kumpakri/diy-differencial-drive-robot/img/scheme_stage2_LDO.png

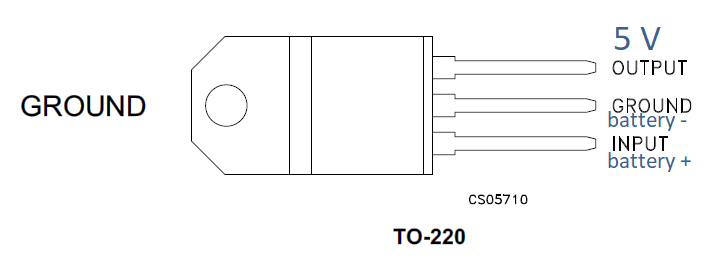
img/scheme_stage2_LDO.png
