kumpakri/diy-differencial-drive-robot/src/main/main.ino

/*
* |ARDUINO PINS USAGE          |
* |----|-----------------------|
* |  2 | encoderRightPin       |
* |  3 | encoderLeftPin        |
* |  4 | sensorSelect0         |
* |  5 | motor2SpeedPin        |
* |  6 | motor1SpeedPin        |
* |  7 | motor1DirAPin         |
* |  8 | motor1DirBPin         |
* |  9 | motor2DirAPin         |
* | 10 | motor2DirBPin         |
* | 11 | sensorSelect1         |
* | 12 | distanceSensorTrigPin |
* | 13 | distanceSensorEchoPin |
*/
#include <string.h>
#include "drive_motors.h"
#include "encoder.h"
#include "distance_sensor.h"
#include "multiplexer.h"

void setup() {
  Serial.begin(9600);
  setupMotors();
  setupEncoders();
  setupDistanceSensor();
  setupMultiplexer();
  setVelocity(0, 0);
}

void loop() {
  updateRPMEncoderRight();
  updateRPMEncoderLeft();
  struct distances dist =  getAllDistances();
  String msg;
  msg += dist.aheadSensorDistance;
  msg += ", ";
  msg += dist.rightSensorDistance;
  msg += ", ";
  msg += dist.leftSensorDistance;
  Serial.println(msg);
}
