kumpakri/diy-differencial-drive-robot/(commit log)

2019-07-27 The wheels can move forward using H-bridge and PWM from Arduino.
2020-07-14 Connected the H-Bridge to the motors.
2020-07-19 Added the motors encoders.
2020-07-20 Added the distance sensor.
2020-07-24 Connected 3 HC-SR04 sensors.
2020-07-29 Fixed up some comment and include.
    [distance_sensor.h, encoder.h, main.ino]
